I2SenseLab/TT-EverythingPMOD/README.md

# PMOD For TT Boards

This PMOD sits between the tiny tapeout board and any standard PMOD to reorder the pinout in such a way to match alternate pmods.
