I2SenseLab/TT-EverythingPMOD/Article/design_files_summary.tex

```latex
\begin{tabu} to \linewidth {|X|X|X[1.2,1]|X[1.6,1]|}
\hline
\textbf{Design filename} & \textbf{File type} & \textbf{Open source license} & \textbf{Location of the file} \\\hline

EverythingPMOD.dip &
Editable PCB layout &
CERN-OHL-W-2.0 &
Zenodo repository \\\hline

EverythingPMOD_Board_Schematic.dch &
Editable schematic &
CERN-OHL-W-2.0 &
Zenodo repository \\\hline

EverythingPMOD_gerber.zip &
PCB manufacturing files &
CERN-OHL-W-2.0 &
Zenodo repository \\\hline

Software/one-to-one &
Example firmware (C++) &
Apache-2.0 &
Git repository / Zenodo repository \\\hline

Software/ula &
Logic analyzer firmware and host software (Rust) &
MIT / Apache-2.0 &
Git repository / Zenodo repository \\\hline

README.md &
Project documentation &
Apache-2.0 &
Git repository / Zenodo repository \\\hline

\end{tabu}

\vskip 0.3cm

\noindent
\textbf{EverythingPMOD.dip}\\
Editable DipTrace PCB layout containing the complete board layout, component placement, routing, and manufacturing information for the EverythingPMOD hardware.

\vskip 0.2cm

\noindent
\textbf{EverythingPMOD\_Board\_Schematic.dch}\\
Editable DipTrace schematic describing the complete electrical design of the hardware.

\vskip 0.2cm

\noindent
\textbf{EverythingPMOD\_gerber.zip}\\
Gerber manufacturing package generated from the PCB design for direct fabrication by commercial PCB manufacturers.

\vskip 0.2cm

\noindent
\textbf{Software/one-to-one}\\
Reference C++ firmware demonstrating basic communication with the hardware and providing a minimal starting point for custom applications.

\vskip 0.2cm

\noindent
\textbf{Software/ula}\\
Complete Rust firmware and supporting software implementing the logic analyzer functionality, together with build scripts and user documentation.

\vskip 0.2cm

\noindent
\textbf{README.md}\\
Top-level project documentation describing repository organization, software build instructions, hardware programming, and basic operation.
```
