I2SenseLab/TT-EverythingPMOD/Article/title.tex

\textbf{Article title}\\
Passthrough PMOD Board for Silicon Validation

\textbf{Authors}\\
*Devin Atkin, Santiago Fuentes, Orly Yadid-Pecht

\textbf{Affiliations}\\
University of Calgary

\textbf{Corresponding author’s email address and Twitter handle}\\ 
dmatkin@ucalgary.ca, @DevinAtkin
