I2SenseLab/TT-EverythingPMOD/Article/hardwarex.tex

% GENERAL INFORMATION: HardwareX is an open access journal established to promote free and open source designing, building and customizing of scientific infrastructure (hardware). For more details on best practices for sharing open hardware see http://www.oshwa.org/sharing-best-practices/

\documentclass[11pt, letterpaper]{article}
\usepackage[utf8]{inputenc}
\usepackage[margin=1.5cm]{geometry}
\usepackage{titlesec}
\usepackage{tabu}
\usepackage{enumitem}
\usepackage{amssymb}
\usepackage{xcolor}
\newlist{selectlist}{itemize}{2}
\setlist[selectlist]{label=$\square$,leftmargin=*,noitemsep,topsep=0pt}

\usepackage{lmodern}

\usepackage{hyperref}

\usepackage[
backend=biber,
style=ieee
]{biblatex}
\addbibresource{references.bib}

\hypersetup{
    colorlinks=true,
    linkcolor=blue,
    filecolor=magenta,      
    urlcolor=blue,
}
 
\urlstyle{same}

% Set up the section label formatting
\titleformat{\section}[block]{\hspace{1em}\bfseries}{\thesection.}{0.5em}{} 
\titleformat{\subsection}[block]{\hspace{1em}}{\thesubsection}{0.5em}{}

\begin{document}
% Create the title block
\begin{flushleft}

\setlength{\parindent}{0pt}
\setlength{\parskip}{10pt}
% \textbf{\large HardwareX article template}

\input{title}
\input{abstract}
\input{keywords}

\newpage
\input{spec_table}
\newpage
\input{hardware_in_context}

\input{hardware_description}

\input{design_files_summary}

\input{bill_of_materials}

\input{operation_instructions}

\input{validation_and_characterization}

\noindent

\input{conclusion}

\noindent

\input{acknowledgements}

\noindent

\input{references}

\end{document}

%> Author manuscript checklist
%> ●	HardwareX is a journal dedicated to the exhaustive and fully open source communication of advances in scientific infrastructure. Upon submission the author declares that all information necessary to reproduce the subject of the submission (e.g. bill of materials, build instructions, calibration procedures, source files, code, and safety considerations) is communicated in full and is accessible for use under an open source license. 
%> ●	Is the subject of the submission under an open source license? Are design files in the preferred format for making modifications? As defined by the Open Source Hardware definition. 
%> ●	Can the hardware be reproduced with the details provided in the submission?
%> ●	Are all relevant design files available on Mendeley Data, the Open Science Framework, or Zenodo repositories, described in the Summary of Design Files document, and clearly documented? (e.g. descriptive file names, commented code, labeled images, etc.) 
%>      ○	If in the Open Science Framework, the repository has be registered? Instructions
%>      ○	If in Zenodo, the repository is open access and is published? Instructions
%>      ○	If in Mendeley Data, the repository is published or the sharable link was included in the additional information of the Editorial Submission interface? Instructions
%> ●	Are visual instructions used when necessary?
%> ●	Is the utility of the hardware to the scientific community? Has a specific scientific application been demonstrated using the hardware?
%> ●	Is the performance of the hardware adequately demonstrated and characterized?
%> ●	Are all potential safety concerns addressed?
%> ●	For more information on the article template consult the Guide to Authors.}
