I2SenseLab/TT-EverythingPMOD/Article/spec_table.tex

\textbf{Specifications table}\\
\textit{Please replace the italicizied instructions in the right column of the table with the relevant information about your hardware.}
\vskip 0.2cm
\tabulinesep=1ex
\begin{tabu} to \linewidth {|X|X[3,l]|}
    \hline  \textbf{Hardware name} & Everything PMOD
    \\
    \hline \textbf{Subject area} & Educational tools and open source alternatives to existing infrastructure
    \\
    \hline \textbf{Hardware type} & Electrical engineering and computer science
    \\ 
    \hline \textbf{Closest commercial analog} & Digital Logic Analyzer
    \\
    \hline \textbf{Open source license} & Apache License 2.0
    \\
    \hline \textbf{Cost of hardware} & \$16
    \\
    \hline \textbf{Source file repository} & https://doi.org/10.17632/smk5yyzz4b.1
    \\
\\\hline
\end{tabu}
\end{flushleft}
