I2SenseLab/TT-EverythingPMOD/Article/acknowledgements.tex

\textbf{Acknowledgements}\\

The authors would like to thank the Tiny Tapeout project and the open-source silicon community for providing an accessible platform for integrated circuit fabrication and validation. Their continued development of open-source ASIC design infrastructure has significantly lowered the barrier to entry for integrated circuit research and education.

The authors also acknowledge the use of large language model (LLM) tools during the preparation of this manuscript. These tools were used to assist with language refinement, grammar, and drafting of manuscript text. All technical content, hardware design decisions, and final manuscript revisions were reviewed and approved by the authors.

Funding: This research did not receive any specific grant from funding agencies in the public, commercial, or not-for-profit sectors.
