I2SenseLab/TT-EverythingPMOD/Hardware/bom.xls

Comment | Designator | Footprint | JLCPCB Part # | Qty | Ext.Price($)
CAP_0805 | C14,C16,C15 | CAP_0805 | C15850 | 15 | 0.00
C165948 | J9 | C165948 | C165948 | 5 | 0.85
C720477 | S1,S2 | C720477 | C720477 | 14 | 0.00
RES_0805 | R7,R6 | RES_0805 | C17594 | 20 | 0.04
HDRRA12W66P254_6X2_1483X175H617 | J3,J5,J1 | HDRRA12W66P254_6X2_1483X175H617 | C60565 | 15 | 0.90
RES_0402_M | R3 | RES_0402_M | C11702 | 5 | 0.00
CAP_0805 | C2,C1 | CAP_0805 | C1705 | 20 | 0.08
ABM8-272-T3_ABR | 12MHZ1 | ABM8-272-T3_ABR | C20625731 | 5 | 1.75
CAP_0805 | C7,C17,C9,C4,C13,C3,C10,C11,C12,C6,C5,C8 | CAP_0805 | C28233 | 60 | 0.34
0806InductorFootprint | L1 | 0806InductorFootprint | C42411119 | 5 | 1.39
RHDRRA12W65P254_6X2_1574X850H520_AP1 | J6,J2,J4 | RHDRRA12W65P254_6X2_1574X850H520_AP1 | C2897426 | 15 | 3.53
QFN81P30_1000X1000X90L40X20T340N | U1 | QFN81P30_1000X1000X90L40X20T340N | C42415655 | 5 | 9.29
SOT223-4P230_700X165L95X70L | U2 | SOT223-4P230_700X165L95X70L | C108495 | 5 | 0.72
SOIC8P127_528X790X216L65X42N | U3 | SOIC8P127_528X790X216L65X42N | C97521 | 5 | 2.78
CAP_0805_M | C19,C18 | CAP_0805_M | C1796 | 20 | 0.13
RES_0805 | R4,R5 | RES_0805 | C17414 | 10 | 0.02
RES_0402_N | R9,R8 | RES_0402_N | C482289 | 20 | 0.00
RES_0805 | R1,R2 | RES_0805 | C17634 | 10 | 0.02
