I2SenseLab/TT-EverythingPMOD/(list of files, drawings)

Other design files:
Hardware/EverythingPMOD.dip
Hardware/EverythingPMOD_Board_Schematic.dch
