I2SenseLab/TT-EverythingPMOD/(commit log)

2024-12-02 Initial Everything PMOD Design
    [EverythingPMOD.dip, EverythingPMOD_Board_Schematic.dch]
2025-04-07 Update to Board
    [EverythingPMOD.dip, EverythingPMOD_Board_Schematic.dch]
2025-04-07 Organize Files into Hardware and Software
    [EverythingPMOD.dip, EverythingPMOD_Board_Schematic.dch]
2025-04-08 Remove the Pico SDK
2026-06-24 Add JLCPCB BOM from fabricated board
    [bom.xls]
2026-06-24 Bill of Materials Summary (REMOVE)
